heatbitinc/bitair-mainboard/3d/Heatsink.STEP

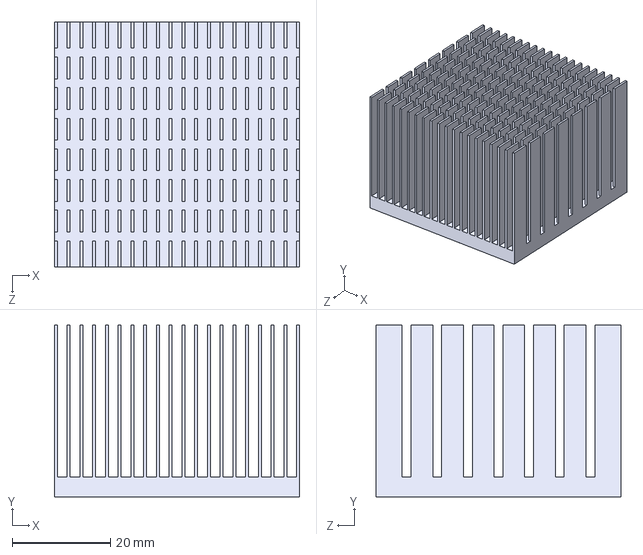
[picture p3: CAD file, 2026-10-29]
3d/Heatsink.STEP
50.0 x 35.0 x 50.0 mm
