heatbitinc/bitair-mainboard/3dshapes/IND-SMD_L10.2-W7.8.step

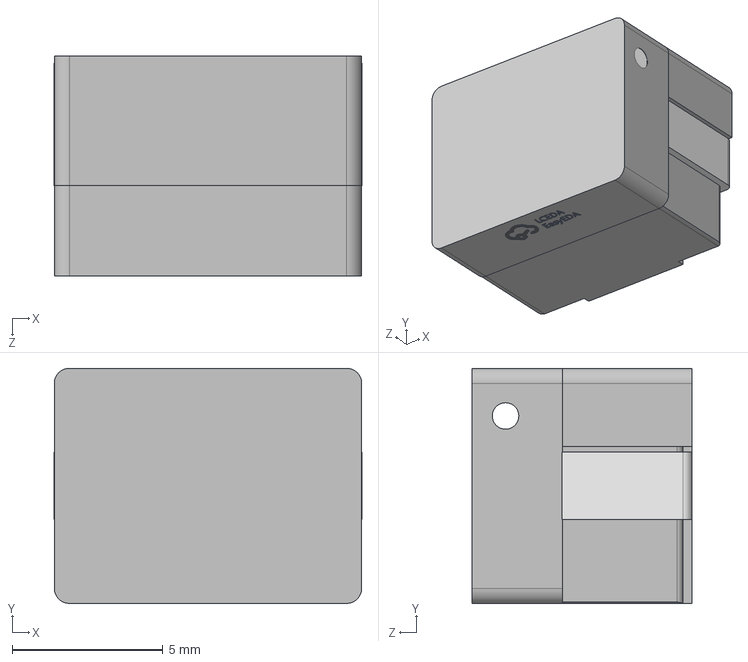
[picture p4: CAD file, 2026-10-29]
3dshapes/IND-SMD_L10.2-W7.8.step
10.2 x 7.81 x 7.31 mm
