heatbitinc/bitair-mainboard/3d/KMS231GPLFS.stp

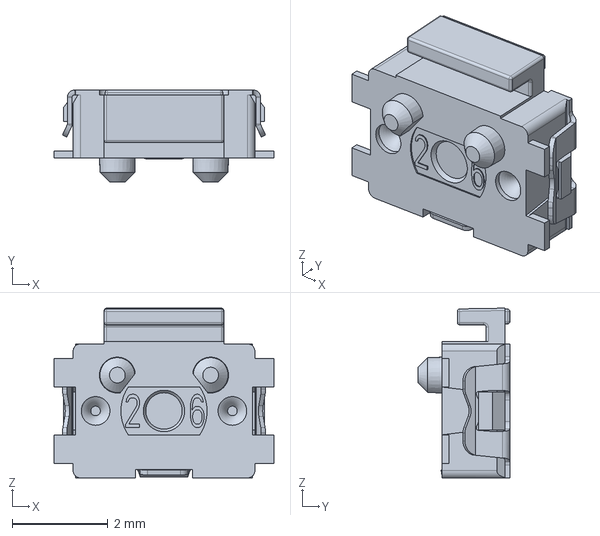
[picture p5: CAD file, 2026-10-29]
3d/KMS231GPLFS.stp
4.60 x 1.92 x 3.55 mm
