heatbitinc/bitair-mainboard/3dshapes/PRPAK-8_L5.1-W6.2-P1.27-LS6.1-BL.step

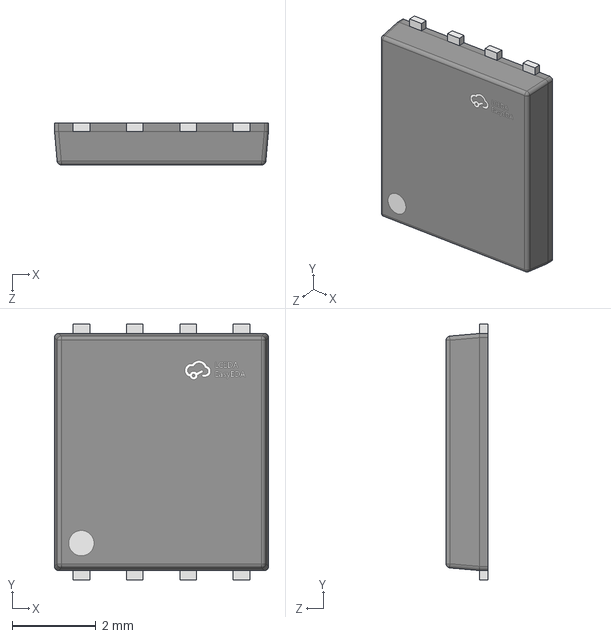
[picture p6: CAD file, 2026-10-29]
3dshapes/PRPAK-8_L5.1-W6.2-P1.27-LS6.1-BL.step
5.10 x 6.10 x 1.00 mm
