heatbitinc/bitair-mainboard/3dshapes/XFCN_PKT-TH_4P-T34069.step

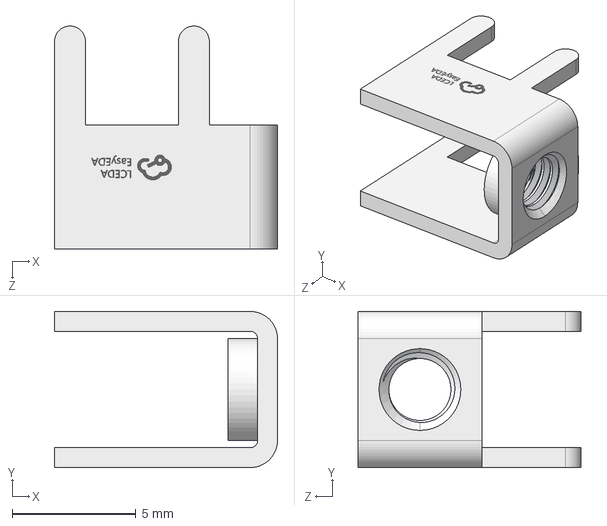
[picture p7: CAD file, 2026-10-29]
3dshapes/XFCN_PKT-TH_4P-T34069.step
9.00 x 6.30 x 9.00 mm
