heatbitinc/bitair-mainboard/3dshapes/SMD_BD5.6-D4.1.step

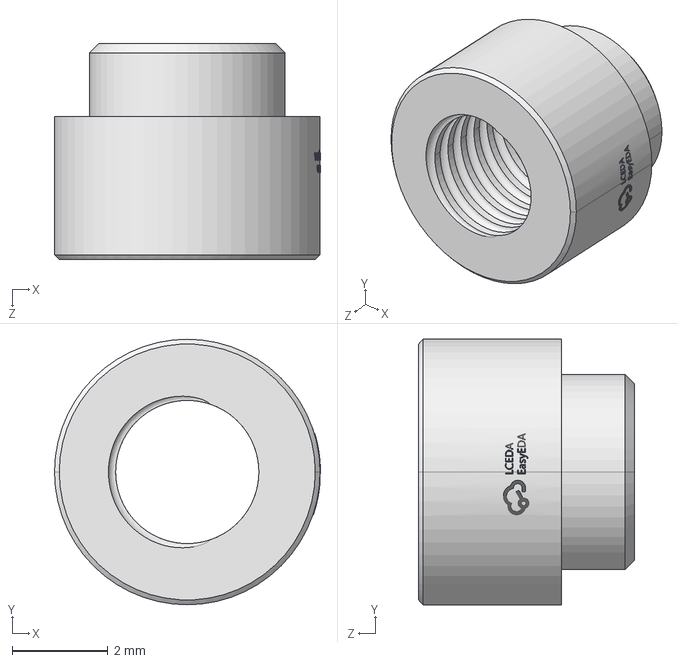
[picture p8: CAD file, 2026-10-29]
3dshapes/SMD_BD5.6-D4.1.step
5.57 x 5.56 x 4.53 mm
