heatbitinc/bitair-mainboard/bitair-mainboard.kicad_pcb

## KiCad design bitair-mainboard.kicad_pcb (2026-10-29)

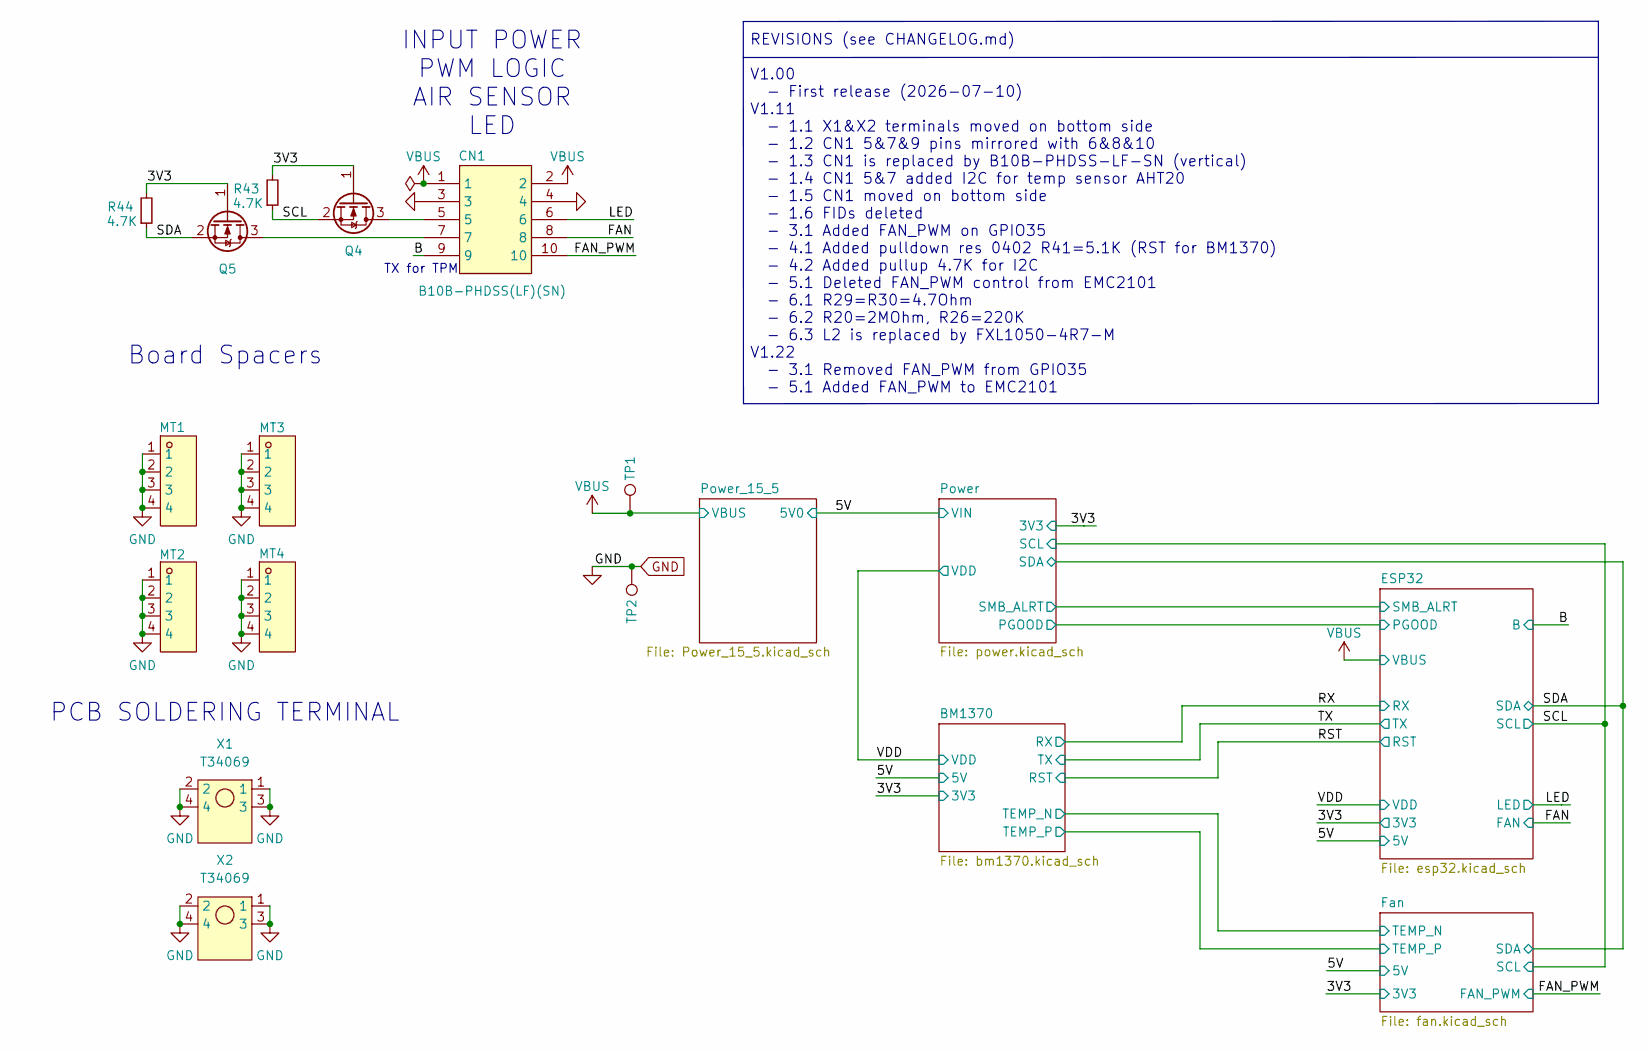
[picture p9: schematic bitair-mainboard.kicad_sch, Bitair MainBoard]

Parts:
CN1: B10B-PHDSS(LF)(SN); CONN-TH_B10B-PHDSS-LF-SN; MPN B10B-PHDSS(LF)(SN); LCSC C471519
MT1, MT2, MT3, MT4: SMTSO3025CTJ; SMD_BD5.6-D4.1; MPN SMTSO3025CTJ; LCSC C2916365
Q4, Q5: 2N7002E; SOT-23; MPN 2N7002ET1G; LCSC C71533
R43, R44: 4.7K; R_0402_1005Metric; LCSC C2906869
TP1, TP2: TestPoint; TestPoint_Pad_D1.5mm
X1, X2: T34069; XFCN_PKT-TH_4P-T34069; MPN T34069; LCSC C481452

Connections:
/3V3: Q4.1 (G), Q5.1 (G), R43.2, R44.2; also elsewhere on the board
/B: CN1.9; also elsewhere on the board
/FAN: CN1.8; also elsewhere on the board
/FAN_PWM: CN1.10; also elsewhere on the board
/LED: CN1.6; also elsewhere on the board
/SCL: Q4.2 (S), R43.1; also elsewhere on the board
/SDA: Q5.2 (S), R44.1; also elsewhere on the board
GND: CN1.3, CN1.4, MT1.1, MT1.2, MT1.3, MT1.4, MT2.1, MT2.2, MT2.3, MT2.4, MT3.1, MT3.2, MT3.3, MT3.4, MT4.1, MT4.2, MT4.3, MT4.4, TP2.1 (1_1), X1.1, X1.2, X1.3, X1.4, X2.1, X2.2, X2.3, X2.4; also elsewhere on the board
unnamed: CN1.5, Q4.3 (D)
unnamed: CN1.7, Q5.3 (D)
VBUS: CN1.1, CN1.2, TP1.1 (1_1); also elsewhere on the board

Notes on the sheet:
Board Spacers
PCB SOLDERING TERMINAL
INPUT POWER PWM LOGIC AIR SENSOR LED
REVISIONS (see CHANGELOG.md) V1.00 - First release (2026-07-10) V1.11 - 1.1 X1&X2 terminals moved on bottom side - 1.2 CN1 5&7&9 pins mirrored with 6&8&10 - 1.3 CN1 is replaced by B10B-PHDSS-LF-SN (vertical) - 1.4 CN1 5&7 added I2C for temp sensor AHT20 - 1.5 CN1 moved on bottom side - 1.6 FIDs del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
TX for TPM

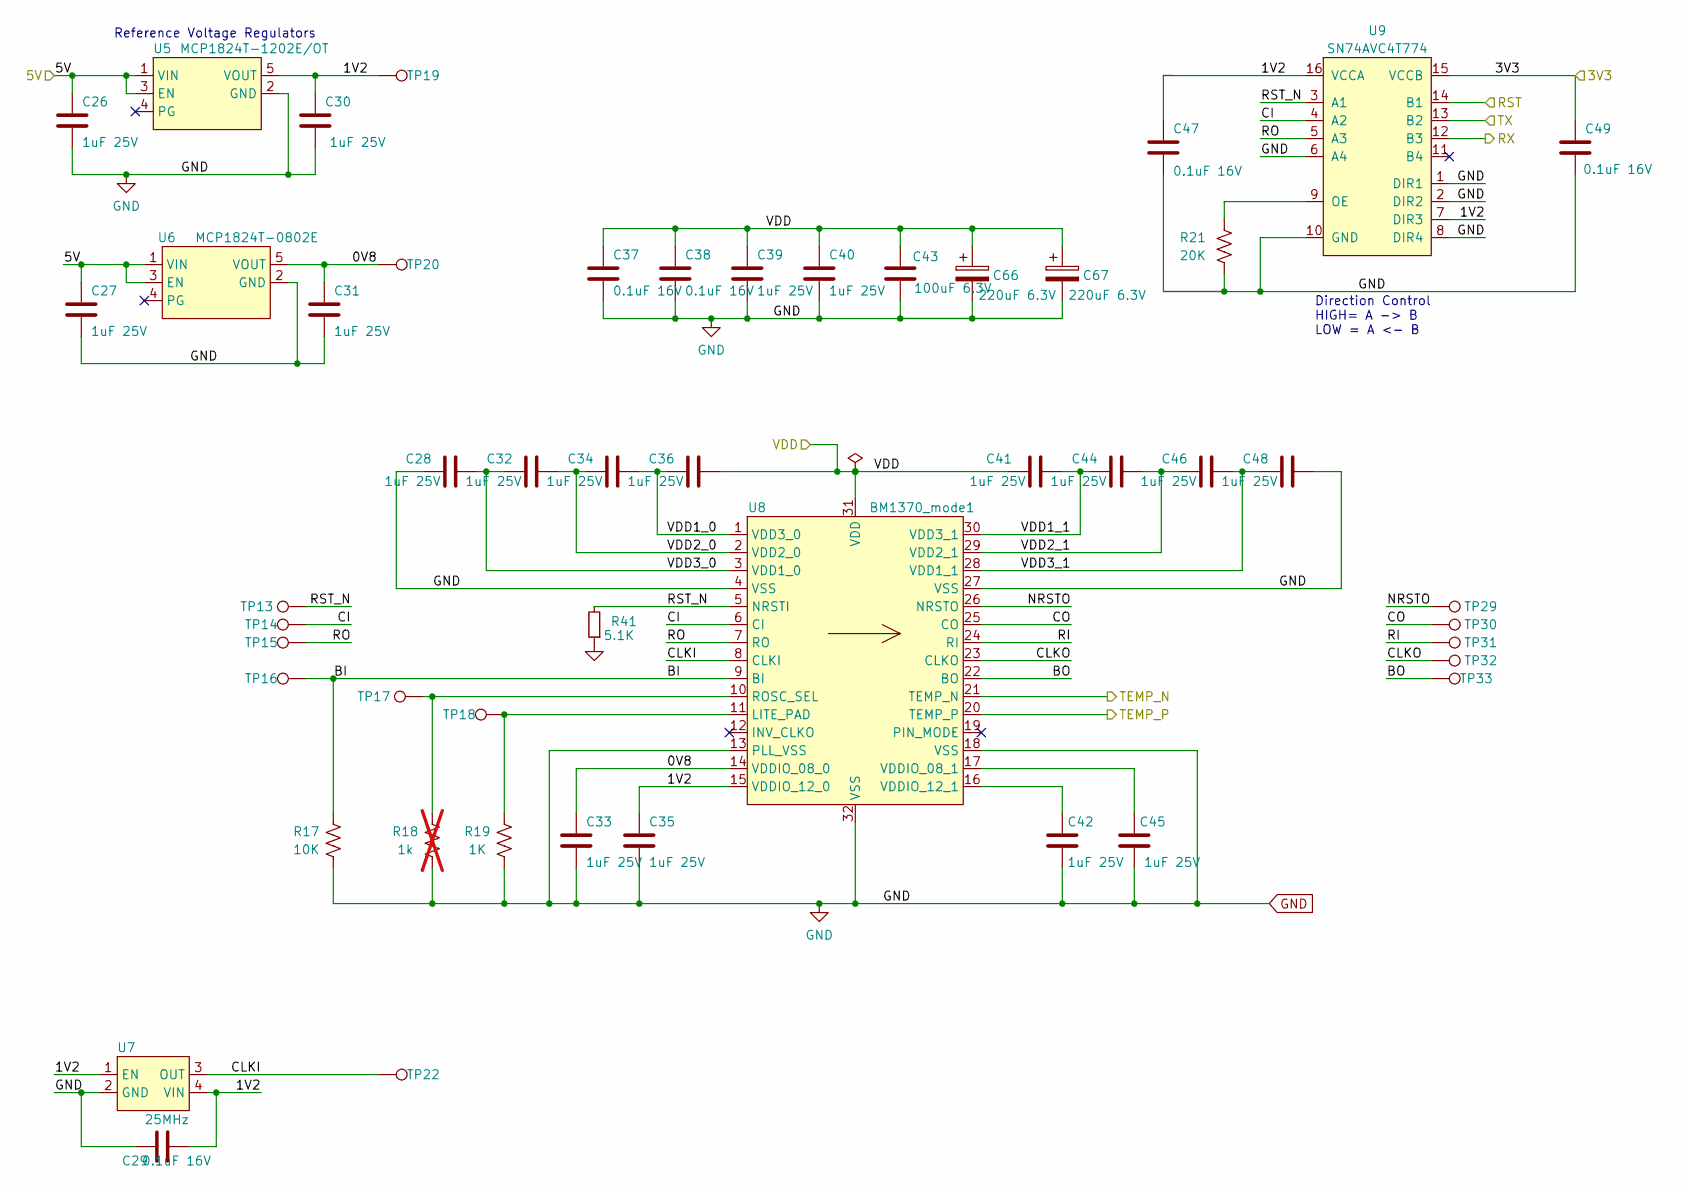
[picture p10: schematic bm1370.kicad_sch, Bitair MainBoard]

Parts:
C26, C27, C28, C30, C31, C32, C33, C34, C35, C36, C39, C40, C41, C42, C44, C45, C46, C48: 1uF 25V; C_0402_1005Metric; LCSC C7467048
C29, C37, C38, C47, C49: 0.1uF 16V; C_0402_1005Metric; DigiKey 1276-1234-1-ND
C43: 100uF 6.3V; C_1206_3216Metric; DigiKey 1276-1782-1-ND
C66, C67: 220uF 6.3V; CAP-SMD_L3.5-W2.8-R-RD; MPN 6TPE220MAZB; LCSC C79111
R17: 10K; R_0402_1005Metric; DigiKey 311-10KJRCT-ND
R18: 1k; R_0402_1005Metric; DigiKey 311-1.00KLRCT-ND; not fitted
R19: 1K; R_0402_1005Metric; DigiKey 311-1.00KLRCT-ND
R21: 20K; R_0402_1005Metric; DigiKey 311-20.0KLRCT-ND
R41: 5.1K; R_0402_1005Metric; LCSC C2906874
TP13, TP14, TP15, TP16, TP17, TP18, TP19, TP20, TP22, TP29, TP30, TP31, TP32, TP33: TestPoint; TestPoint_Pad_D1.5mm
U5: MCP1824T-1202E/OT; SOT-23-5; MPN MCP1824T-1202E/OT; DigiKey MCP1824T-1202E/OTCT-ND
U6: MCP1824T-0802E; SOT-23-5; MPN MCP1824T-0802E/OT; DigiKey MCP1824T-0802E/OTCT-ND
U7: 25MHz; SMD3225-4P; MPN SX3M25.000E20F30THN; LCSC C5137262
U8: BM1370_mode1; BM1370; MPN BM1370
U9: SN74AVC4T774; TSSOP-16_4.4x5mm_P0.65mm; MPN SN74AVC4T774PWR; DigiKey 296-24739-1-ND

Connections:
5V0: C26.1, C27.1, U5.1 (VIN), U5.3 (EN), U6.1 (VIN), U6.3 (EN); also elsewhere on the board
/3V3: C49.1, U9.15 (VCCB); also elsewhere on the board
/BM1370/0V8: C31.1, C33.1, TP20.1 (1_1), U6.5 (VOUT), U8.14 (VDDIO_08_0)
/BM1370/1V2: C29.2, C30.1, C35.1, C47.1, TP19.1 (1_1), U5.5 (VOUT), U7.1 (EN), U7.4 (VIN), U8.15 (VDDIO_12_0), U9.7 (DIR3), U9.16 (VCCA)
/BM1370/BI: R17.2, TP16.1 (1_1), U8.9 (BI)
/BM1370/BO: TP33.1 (1_1), U8.22 (BO)
/BM1370/CI: TP14.1 (1_1), U8.6 (CI), U9.4 (A2)
/BM1370/CLKI: TP22.1 (1_1), U7.3 (OUT), U8.8 (CLKI)
/BM1370/CLKO: TP32.1 (1_1), U8.23 (CLKO)
/BM1370/CO: TP30.1 (1_1), U8.25 (CO)
/BM1370/NRSTO: TP29.1 (1_1), U8.26 (NRSTO)
/BM1370/RI: TP31.1 (1_1), U8.24 (RI)
/BM1370/RO: TP15.1 (1_1), U8.7 (RO), U9.5 (A3)
/BM1370/RST_N: R41.2, TP13.1 (1_1), U8.5 (NRSTI), U9.3 (A1)
/BM1370/VDD1_0: C34.2, C36.1, U8.1 (VDD3_0)
/BM1370/VDD1_1: C41.2, C44.1, U8.30 (VDD3_1)
/BM1370/VDD2_0: C32.2, C34.1, U8.2 (VDD2_0)
/BM1370/VDD2_1: C44.2, C46.1, U8.29 (VDD2_1)
/BM1370/VDD3_0: C28.2, C32.1, U8.3 (VDD1_0)
/BM1370/VDD3_1: C46.2, C48.1, U8.28 (VDD1_1)
/Fan/TEMP_N: U8.21 (TEMP_N); also elsewhere on the board
/Fan/TEMP_P: U8.20 (TEMP_P); also elsewhere on the board
/RST: U9.14 (B1); also elsewhere on the board
/RX: U9.12 (B3); also elsewhere on the board
/TX: U9.13 (B2); also elsewhere on the board
/VDD: C36.2, C37.1, C38.1, C39.1, C40.1, C41.1, C43.1, C66.1, C67.1, U8.31 (VDD); also elsewhere on the board
GND: C26.2, C27.2, C28.1, C29.1, C30.2, C31.2, C33.2, C35.2, C37.2, C38.2, C39.2, C40.2, C42.2, C43.2, C45.2, C47.2, C48.2, C49.2, C66.2, C67.2, R17.1, R18.1, R19.1, R21.1, R41.1, U5.2 (GND), U6.2 (GND), U7.2 (GND), U8.4 (VSS), U8.13 (PLL_VSS), U8.18 (VSS), U8.27 (VSS), U8.32 (VSS), U9.1 (DIR1), U9.2 (DIR2), U9.6 (A4), U9.8 (DIR4), U9.10 (GND); also elsewhere on the board
unnamed: R19.2, TP18.1 (1_1), U8.11 (LITE_PAD)
unnamed: R18.2, TP17.1 (1_1), U8.10 (ROSC_SEL)
unnamed: C45.1, U8.17 (VDDIO_08_1)
unnamed: C42.1, U8.16 (VDDIO_12_1)
unnamed: R21.2, U9.9 (OE)

Notes on the sheet:
Reference Voltage Regulators
Direction Control HIGH= A -> B LOW = A <- B

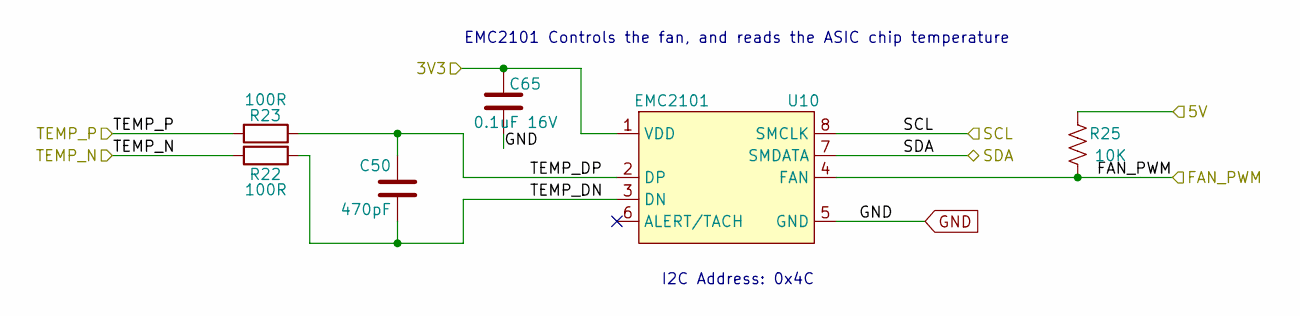
[picture p11: schematic fan.kicad_sch, Bitair MainBoard]

Parts:
C50: 470pF; C_0402_1005Metric; DigiKey 1276-1566-1-ND
C65: 0.1uF 16V; C_0402_1005Metric; LCSC C159816
R22, R23: 100R; R_0402_1005Metric; LCSC C144808
R25: 10K; R_0402_1005Metric; DigiKey 311-10KJRCT-ND
U10: EMC2101; TSSOP-8_3x3mm_P0.65mm; MPN EMC2101-R-ACZL-TR; DigiKey EMC2101-R-ACZL-CT-ND

Connections:
5V0: R25.2; also elsewhere on the board
/3V3: C65.1, U10.1 (VDD); also elsewhere on the board
/FAN_PWM: R25.1, U10.4 (FAN); also elsewhere on the board
/Fan/TEMP_DN: C50.2, R22.1, U10.3 (DN)
/Fan/TEMP_DP: C50.1, R23.1, U10.2 (DP)
/Fan/TEMP_N: R22.2; also elsewhere on the board
/Fan/TEMP_P: R23.2; also elsewhere on the board
/SCL: U10.8 (SMCLK); also elsewhere on the board
/SDA: U10.7 (SMDATA); also elsewhere on the board
GND: C65.2, U10.5 (GND); also elsewhere on the board

Notes on the sheet:
EMC2101 Controls the fan, and reads the ASIC chip temperature
I2C Address: 0x4C

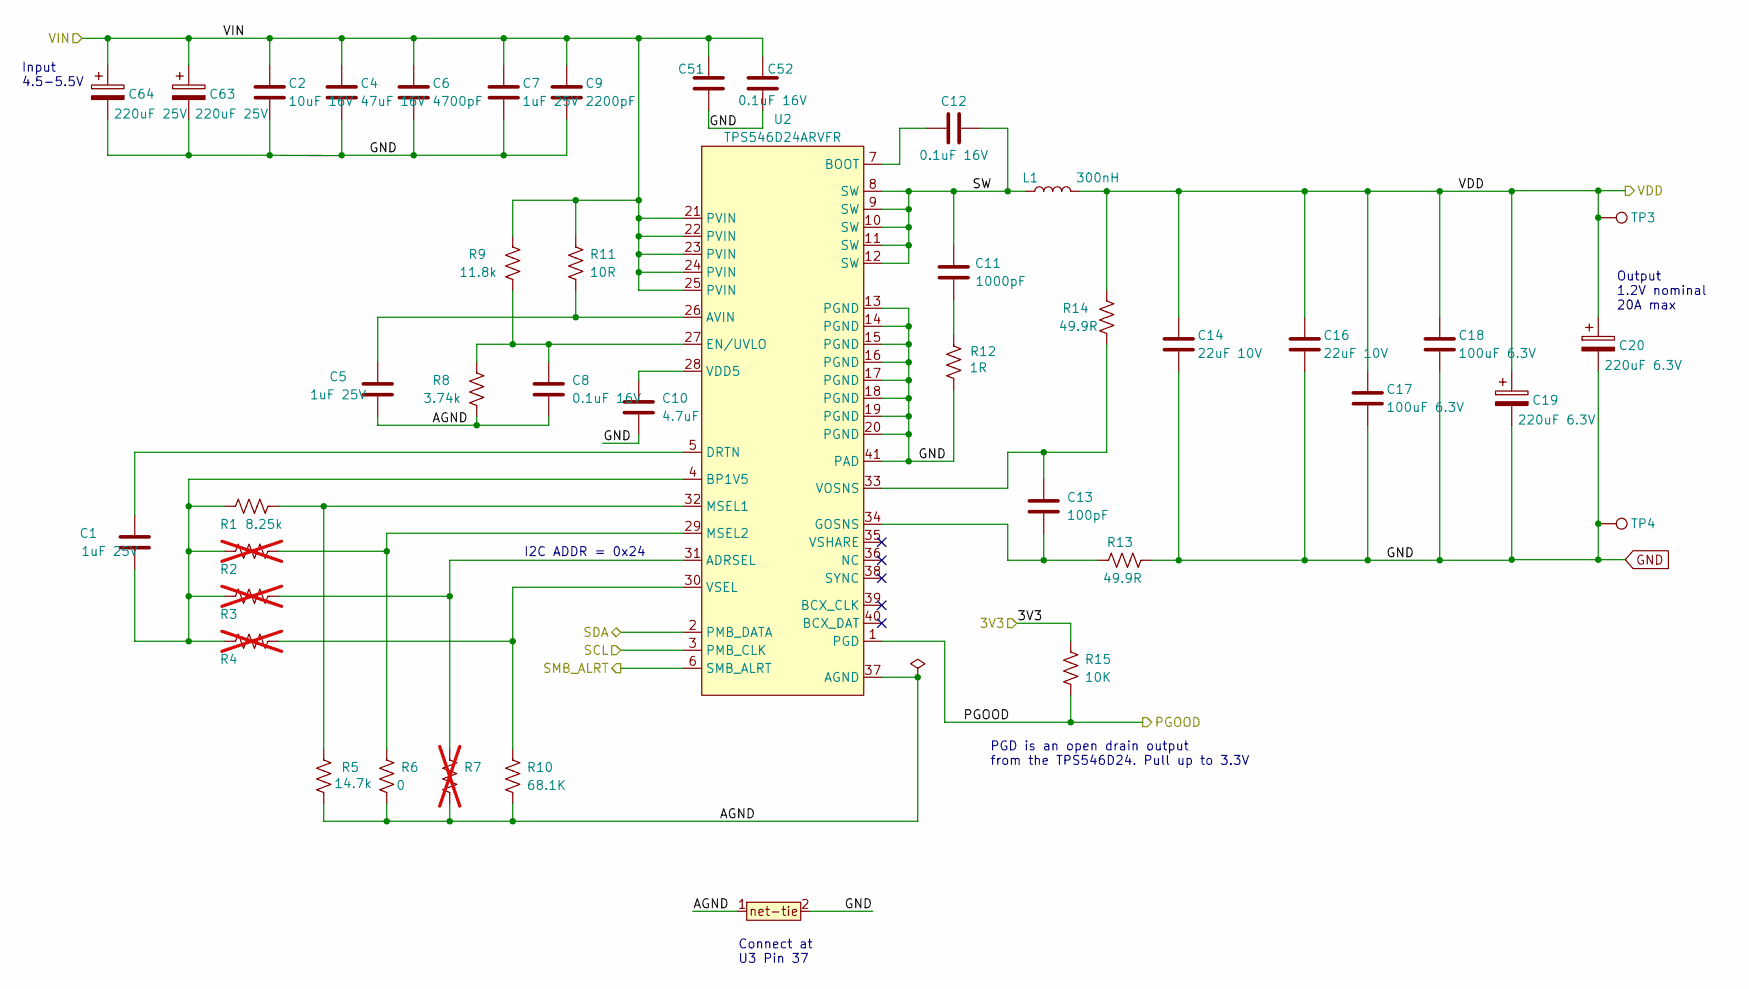
[picture p12: schematic power.kicad_sch, Bitair MainBoard]

Parts:
C1, C5, C7: 1uF 25V; C_0402_1005Metric; LCSC C7467048
C2: 10uF 16V; C_0805_2012Metric; DigiKey 1276-1096-1-ND
C4, C51: 47uF 16V; C_1210_3225Metric; DigiKey 1276-3376-1-ND
C6: 4700pF; C_0402_1005Metric; DigiKey 490-1309-1-ND
C8, C12, C52: 0.1uF 16V; C_0402_1005Metric; DigiKey 1276-1234-1-ND
C9: 2200pF; C_0402_1005Metric; DigiKey 490-8257-1-ND
C10: 4.7uF; C_0402_1005Metric; DigiKey 490-14306-1-ND
C11: 1000pF; C_0805_2012Metric; DigiKey 311-1127-1-ND
C13: 100pF; C_0402_1005Metric; DigiKey 732-7431-1-ND
C14, C16: 22uF 10V; C_0805_2012Metric; DigiKey 490-10746-1-ND
C17, C18: 100uF 6.3V; C_1206_3216Metric; DigiKey 1276-1782-1-ND
C19, C20: 220uF 6.3V; CAP-SMD_L3.5-W2.8-R-RD; MPN 6TPE220MAZB; LCSC C79111
C63, C64: 220uF 25V; CP_Elec_6.3x7.9; MPN JVJ25V220M6x8; LCSC C51018389
L1: 300nH; SLC1175-271MEC_COC; MPN FP1007R3-R30-R; LCSC C2638821
R1: 8.25k; R_0402_1005Metric; DigiKey 311-8.25KLRCT-ND
R2, R3, R4, R7: R_0402_1005Metric; not fitted
R5: 14.7k; R_0402_1005Metric; DigiKey YAG2984CT-ND
R6: 0; R_0402_1005Metric; DigiKey 311-0.0JRCT-ND
R8: 3.74k; R_0402_1005Metric; DigiKey 311-3.74KLRCT-ND
R9: 11.8k; R_0402_1005Metric; DigiKey YAG2958CT-ND
R10: 68.1K; R_0402_1005Metric; DigiKey YAG3213CT-ND
R11: 10R; R_0402_1005Metric; DigiKey 311-10.0LRCT-ND
R12: 1R; R_1206_3216Metric; DigiKey CSR1206FT1R00CT-ND
R13, R14: 49.9R; R_0402_1005Metric; DigiKey 311-49.9LRCT-ND
R15: 10K; R_0402_1005Metric; DigiKey 311-10KJRCT-ND
T1: net-tie; NetTie-0.25mm
TP3, TP4: TestPoint; TestPoint_Pad_D1.5mm
U2: TPS546D24ARVFR; LQFN40-CLIP; MPN TPS546D24ARVFR; DigiKey 296-TPS546D24ARVFRCT-ND

Connections:
5V0: C2.1, C4.1, C6.1, C7.1, C9.1, C51.1, C52.1, C63.1, C64.1, R9.1, R11.1, U2.21 (PVIN), U2.22 (PVIN), U2.23 (PVIN), U2.24 (PVIN), U2.25 (PVIN); also elsewhere on the board
/3V3: R15.2; also elsewhere on the board
/ESP32/SMB_ALRT: U2.6 (SMB_ALRT); also elsewhere on the board
/Power/AGND: C5.1, C8.2, R5.1, R6.2, R7.2, R8.2, R10.2, T1.1, U2.37 (AGND)
/Power/PGOOD: R15.1, U2.1 (PGD); also elsewhere on the board
/Power/SW: C11.2, C12.2, L1.1, U2.8 (SW), U2.9 (SW), U2.10 (SW), U2.11 (SW), U2.12 (SW)
/SCL: U2.3 (PMB_CLK); also elsewhere on the board
/SDA: U2.2 (PMB_DATA); also elsewhere on the board
/VDD: C14.1, C16.1, C17.1, C18.1, C19.1, C20.1, L1.2, R14.1, TP3.1 (1_1); also elsewhere on the board
GND: C2.2, C4.2, C6.2, C7.2, C9.2, C10.2, C14.2, C16.2, C17.2, C18.2, C19.2, C20.2, C51.2, C52.2, C63.2, C64.2, R12.1, R13.2, T1.2, TP4.1 (1_1), U2.13 (PGND), U2.14 (PGND), U2.15 (PGND), U2.16 (PGND), U2.17 (PGND), U2.18 (PGND), U2.19 (PGND), U2.20 (PGND), U2.41 (PAD); also elsewhere on the board
unnamed: C11.1, R12.2
unnamed: R3.2, R7.1, U2.31 (ADRSEL)
unnamed: C5.2, R11.2, U2.26 (AVIN)
unnamed: C12.1, U2.7 (BOOT)
unnamed: C1.2, R1.1, R2.1, R3.1, R4.1, U2.4 (BP1V5)
unnamed: C1.1, U2.5 (DRTN)
unnamed: C8.1, R8.1, R9.2, U2.27 (EN/UVLO)
unnamed: C13.2, R13.1, U2.34 (GOSNS)
unnamed: R1.2, R5.2, U2.32 (MSEL1)
unnamed: R2.2, R6.1, U2.29 (MSEL2)
unnamed: C10.1, U2.28 (VDD5)
unnamed: C13.1, R14.2, U2.33 (VOSNS)
unnamed: R4.2, R10.1, U2.30 (VSEL)

Notes on the sheet:
Input 4.5-5.5V
PGD is an open drain output from the TPS546D24. Pull up to 3.3V
I2C ADDR = 0x24
Output 1.2V nominal 20A max
Connect at U3 Pin 37

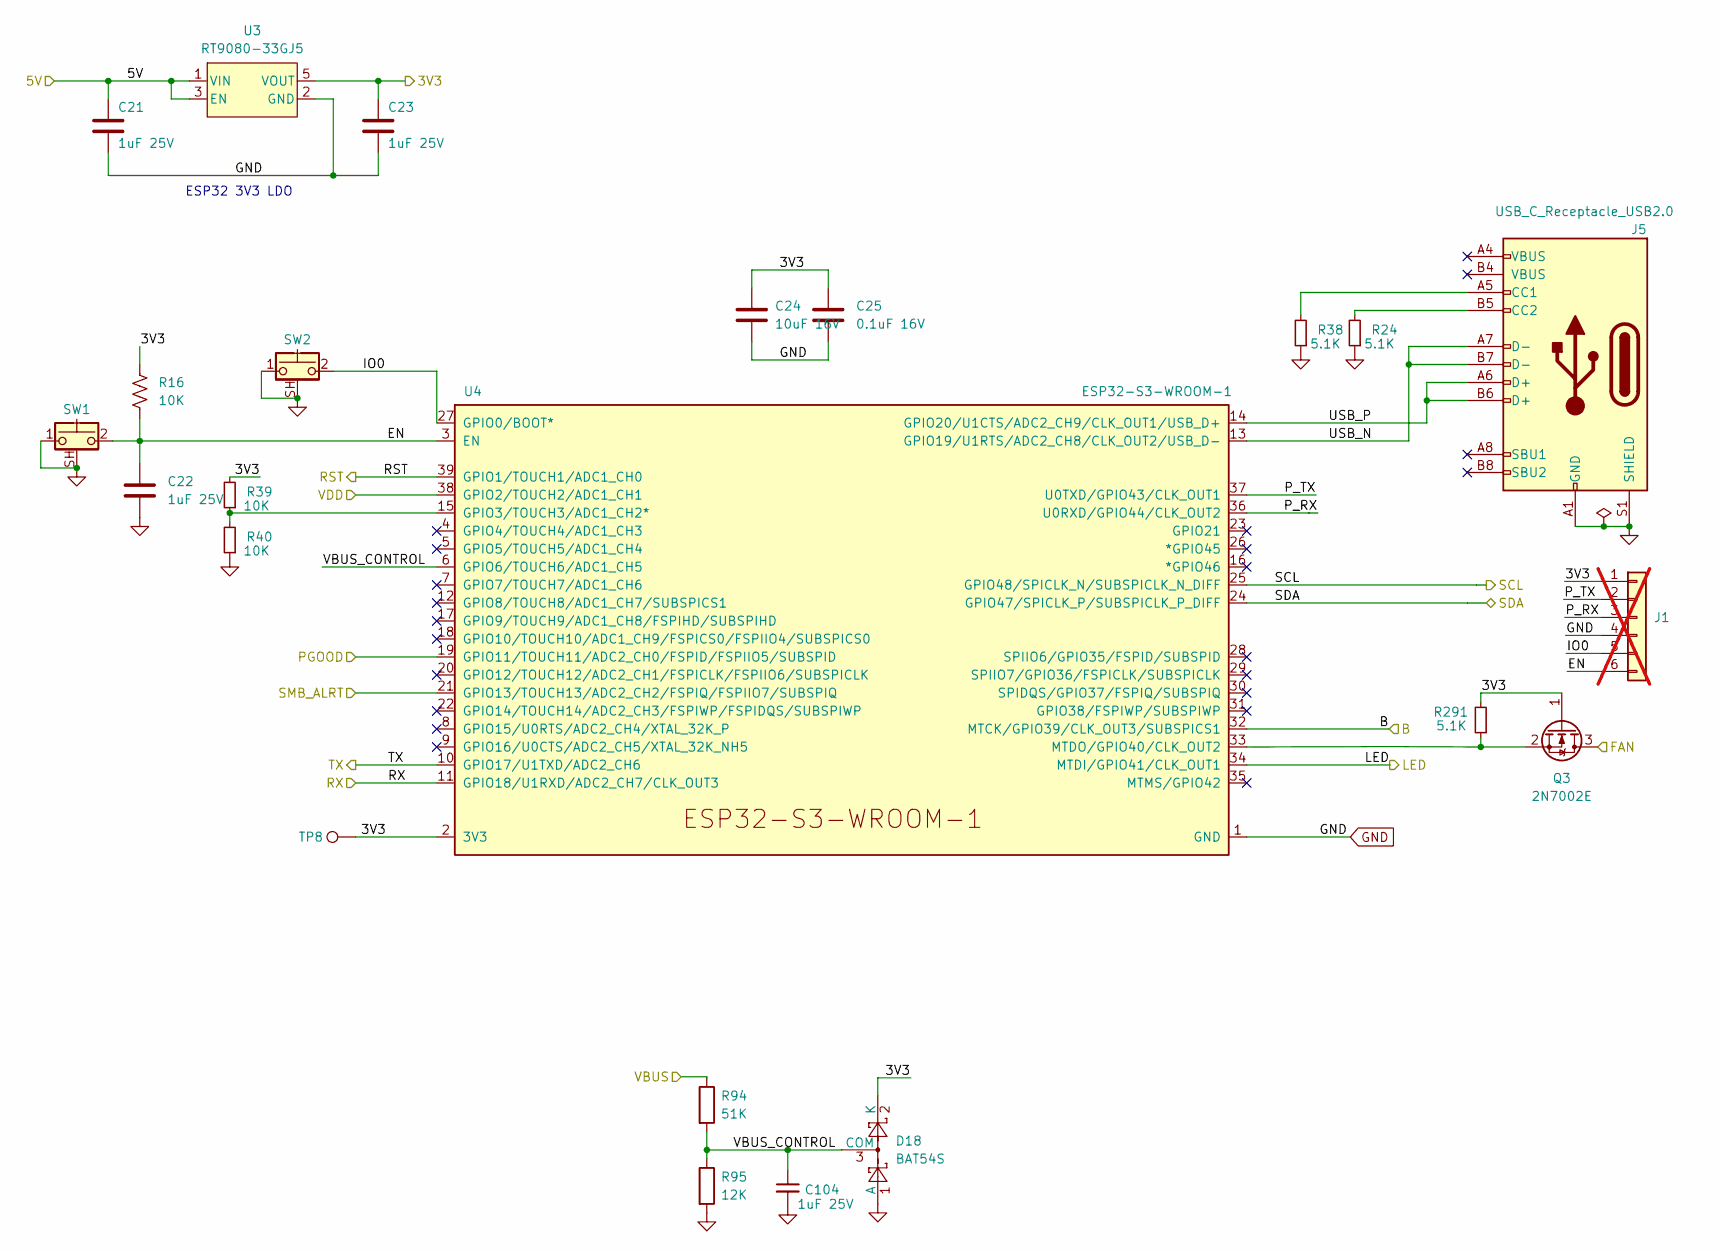
[picture p13: schematic esp32.kicad_sch, Bitair MainBoard]

Parts:
C21, C22, C23, C104: 1uF 25V; C_0402_1005Metric; LCSC C7467048
C24: 10uF 16V; C_0805_2012Metric; DigiKey 1276-1096-1-ND
C25: 0.1uF 16V; C_0402_1005Metric; DigiKey 1276-1234-1-ND
D18: BAT54S; SOT-23; MPN BAT54S; LCSC C19726
J1: Conn_01x06; PinHeader_1x06_P1.27mm_Vertical; MPN PZ254V-11-06P; LCSC C492405; not fitted
J5: USB_C_Receptacle_USB2.0; USB_C_Receptacle_GCT_USB4105-xx-A; MPN USB4105-GF-A; DigiKey 2073-USB4105-GF-ACT-ND
Q3: 2N7002E; SOT-23; MPN 2N7002ET1G; LCSC C71533
R16: 10K; R_0402_1005Metric; DigiKey 311-10KJRCT-ND
R24, R38, R291: 5.1K; R_0402_1005Metric; LCSC C2906874
R39, R40: 10K; R_0402_1005Metric; LCSC C60490
R94: 51K; R_0402_1005Metric; LCSC C409055
R95: 12K; R_0402_1005Metric; LCSC C2692918
SW1, SW2: CK_KMS2xxG; SW_SPST_CK_KMS2xxGP; MPN KMS231GLFS; LCSC C221703
TP8: TestPoint; TestPoint_Pad_D1.5mm
U3: RT9080-33GJ5; MPN RT9080-33GJ5; DigiKey 1028-1509-1-ND
U4: ESP32-S3-WROOM-1; MPN ESP32-S3-WROOM-1-N16R8; DigiKey 1965-ESP32-S3-WROOM-1-N16R8CT-ND

Connections:
5V0: C21.1, U3.1 (VIN), U3.3 (EN); also elsewhere on the board
/3V3: C23.1, C24.1, C25.1, D18.2 (K), J1.1, Q3.1 (G), R16.1, R39.2, R291.2, TP8.1 (1_1), U3.5 (VOUT), U4.2 (3V3); also elsewhere on the board
/B: U4.32 (MTCK/GPIO39/CLK_OUT3/SUBSPICS1); also elsewhere on the board
/ESP32/EN: C22.1, J1.6, R16.2, SW1.2, U4.3 (EN)
/ESP32/IO0: J1.5, SW2.2, U4.27 (GPIO0/BOOT*)
/ESP32/P_RX: J1.3, U4.36 (U0RXD/GPIO44/CLK_OUT2)
/ESP32/P_TX: J1.2, U4.37 (U0TXD/GPIO43/CLK_OUT1)
/ESP32/SMB_ALRT: U4.21 (GPIO13/TOUCH13/ADC2_CH2/FSPIQ/FSPIIO7/S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); also elsewhere on the board
/ESP32/USB_N: J5.A7 (D-), J5.B7 (D-), U4.13 (GPIO19/U1RTS/ADC2_CH8/CLK_OUT2/USB_D-)
/ESP32/USB_P: J5.A6 (D+), J5.B6 (D+), U4.14 (GPIO20/U1CTS/ADC2_CH9/CLK_OUT1/USB_D+)
/ESP32/VBUS_CONTROL: C104.1, D18.3 (COM), R94.2, R95.1, U4.6 (GPIO6/TOUCH6/ADC1_CH5)
/FAN: Q3.3 (D); also elsewhere on the board
/LED: U4.34 (MTDI/GPIO41/CLK_OUT1); also elsewhere on the board
/Power/PGOOD: U4.19 (GPIO11/TOUCH11/ADC2_CH0/FSPID/FSPIIO5/S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); also elsewhere on the board
/RST: U4.39 (GPIO1/TOUCH1/ADC1_CH0); also elsewhere on the board
/RX: U4.11 (GPIO18/U1RXD/ADC2_CH7/CLK_OUT3); also elsewhere on the board
/SCL: U4.25 (GPIO48/SPICLK_N/SUBSPICLK_N_DIFF); also elsewhere on the board
/SDA: U4.24 (GPIO47/SPICLK_P/SUBSPICLK_P_DIFF); also elsewhere on the board
/TX: U4.10 (GPIO17/U1TXD/ADC2_CH6); also elsewhere on the board
/VDD: U4.38 (GPIO2/TOUCH2/ADC1_CH1); also elsewhere on the board
GND: C21.2, C22.2, C23.2, C24.2, C25.2, C104.2, D18.1 (A), J1.4, J5.A1 (GND), J5.B1 (GND), J5.S1 (SHIELD), R24.1, R38.1, R40.1, R95.2, SW1.1, SW1.SH (B), SW2.1, SW2.SH (B), U3.2 (GND), U4.1 (GND), U4.40 (GND), U4.41 (GND); also elsewhere on the board
unnamed: J5.A5 (CC1), R38.2
unnamed: J5.B5 (CC2), R24.2
unnamed: Q3.2 (S), R291.1, U4.33 (MTDO/GPIO40/CLK_OUT2)
unnamed: R39.1, R40.2, U4.15 (GPIO3/TOUCH3/ADC1_CH2*)
VBUS: R94.1; also elsewhere on the board

Notes on the sheet:
ESP32 3V3 LDO

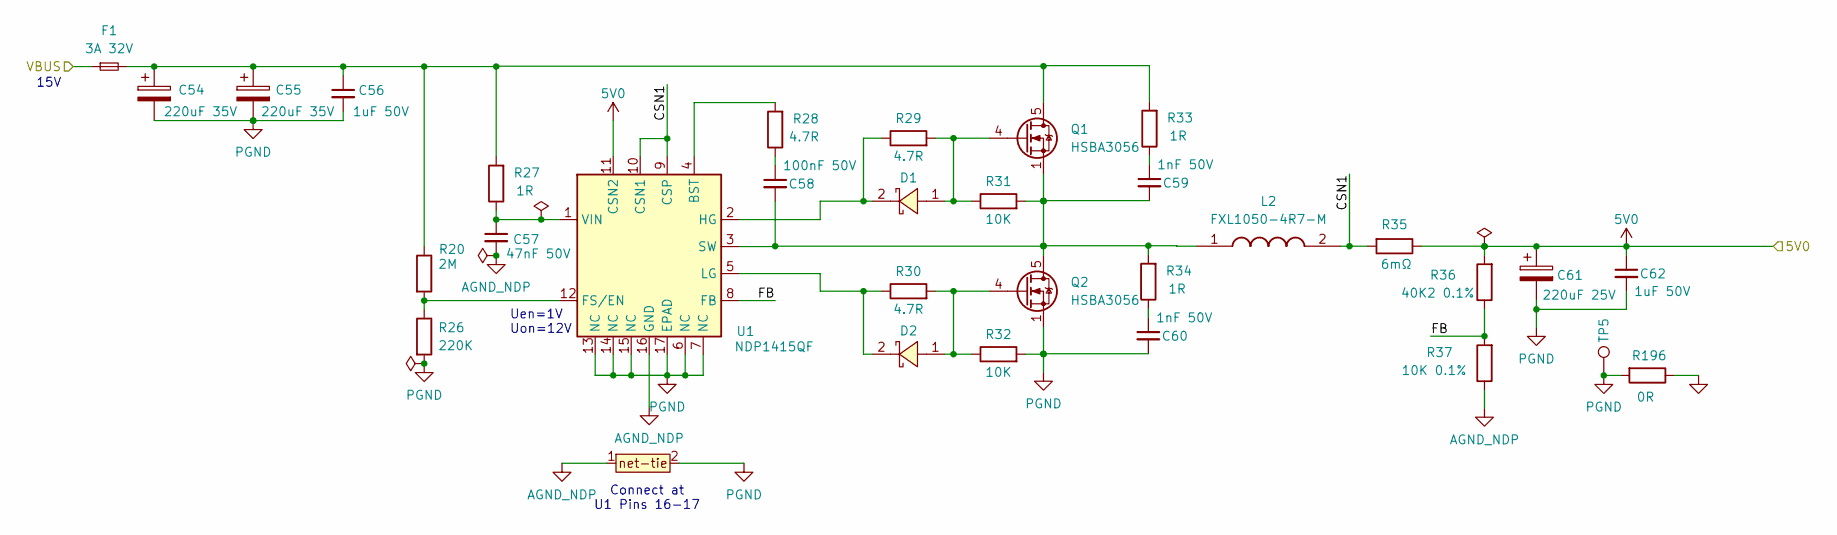
[picture p14: schematic Power_15_5.kicad_sch, Bitair MainBoard]

Parts:
C54, C55: 220uF 35V; CP_Elec_6.3x7.9; MPN JVJ35V220M6x8; LCSC C49256854
C56, C62: 1uF 50V; C_1206_3216Metric; LCSC C1848
C57: 47nF 50V; C_0805_2012Metric; LCSC C107154
C58: 100nF 50V; C_0603_1608Metric; LCSC C1591
C59, C60: 1nF 50V; C_0805_2012Metric; LCSC C94121
C61: 220uF 25V; CP_Elec_6.3x7.9; MPN JVJ25V220M6x8; LCSC C51018389
D1, D2: BAT46W; SOD-123_L2.7-W1.6-LS3.7-FD; MPN BAT46W; LCSC C7420332
F1: 3A 32V; Fuse_1206_3216Metric; MPN S1206-F-3.0A; LCSC C845163
L2: FXL1050-4R7-M; IND-SMD_L11.5-W10.0; MPN FXL1050-4R7-M; LCSC C5359261
Q1, Q2: HSBA3056; PRPAK-8_L5.1-W6.2-P1.27-LS6.1-BL; MPN HSBA3056; LCSC C701049
R20: 2M; R_0402_1005Metric; LCSC C138014
R26: 220K; R_0402_1005Metric; LCSC C2909335
R27: 1R; R_1206_3216Metric; LCSC C20476230
R28: 4.7R; R_0805_2012Metric; LCSC C2828871
R29, R30: 4.7R; R_0603_1608Metric; LCSC C2907035
R31, R32: 10K; R_0603_1608Metric; LCSC C98220
R33, R34: 1R; R_0805_2012Metric; LCSC C2907233
R35: 6mΩ; R_0805_2012Metric; MPN RLM10FTSMR006; LCSC C163092
R36: 40K2 0.1%; R_0603_1608Metric; LCSC C374525
R37: 10K 0.1%; R_0603_1608Metric; LCSC C95204
R196: 0R; R_1210_3225Metric; LCSC C2974058
T2: net-tie; NetTie-0.25mm
TP5: TestPoint; TestPoint_Pad_D1.5mm
U1: NDP1415QF; QFN-16_L3.0-W3.0-P0.50-BL-EP1.7; MPN NDP1415QF; LCSC C7420580

Connections:
5V0: C61.1, C62.1, R35.1, R36.2, U1.11 (CSN2); also elsewhere on the board
/Power_15_5/CSN1: L2.2, R35.2, U1.9 (CSP), U1.10 (CSN1)
/Power_15_5/FB: R36.1, R37.2, U1.8 (FB)
AGND_NDP: C57.2, R37.1, T2.1, U1.16 (GND)
GND: R196.1; also elsewhere on the board
unnamed: C54.1, C55.1, C56.1, F1.2, Q1.5 (D), Q1.6 (D), Q1.7 (D), Q1.8 (D), Q1.9 (D), R20.1, R27.2, R33.2
unnamed: C58.1, R28.1
unnamed: C59.1, R33.1
unnamed: C60.1, R34.1
unnamed: D1.1, Q1.4 (G), R29.2, R31.1
unnamed: D2.1, Q2.4 (G), R30.2, R32.1
unnamed: R28.2, U1.4 (BST)
unnamed: R20.2, R26.1, U1.12 (FS/EN)
unnamed: D1.2, R29.1, U1.2 (HG)
unnamed: D2.2, R30.1, U1.5 (LG)
unnamed: C58.2, C59.2, L2.1, Q1.1 (S), Q1.2 (S), Q1.3 (S), Q2.5 (D), Q2.6 (D), Q2.7 (D), Q2.8 (D), Q2.9 (D), R31.2, R34.2, U1.3 (SW)
unnamed: C57.1, R27.1, U1.1 (VIN)
PGND: C54.2, C55.2, C56.2, C60.2, C61.2, C62.2, Q2.1 (S), Q2.2 (S), Q2.3 (S), R26.2, R32.2, R196.2, T2.2, TP5.1 (1_1), U1.6 (NC), U1.7 (NC), U1.13 (NC), U1.14 (NC), U1.15 (NC), U1.17 (EPAD)
VBUS: F1.1; also elsewhere on the board

Notes on the sheet:
Connect at U1 Pins 16-17
Uen=1V Uon=12V
15V

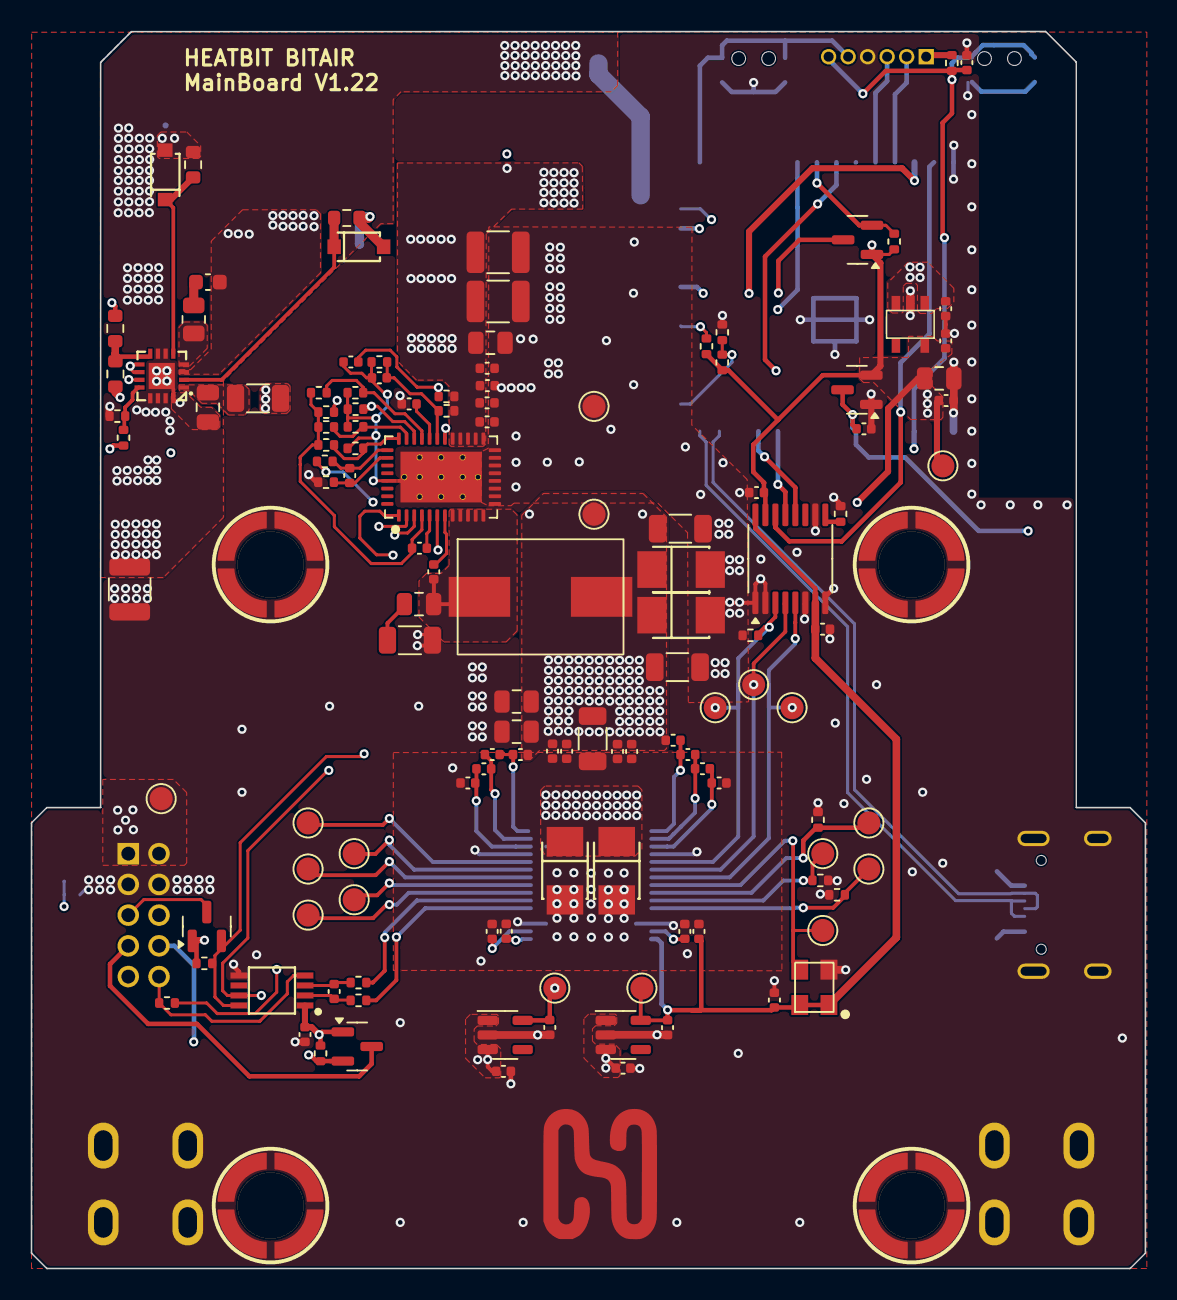
[picture p15: board bitair-mainboard.kicad_pcb from above]

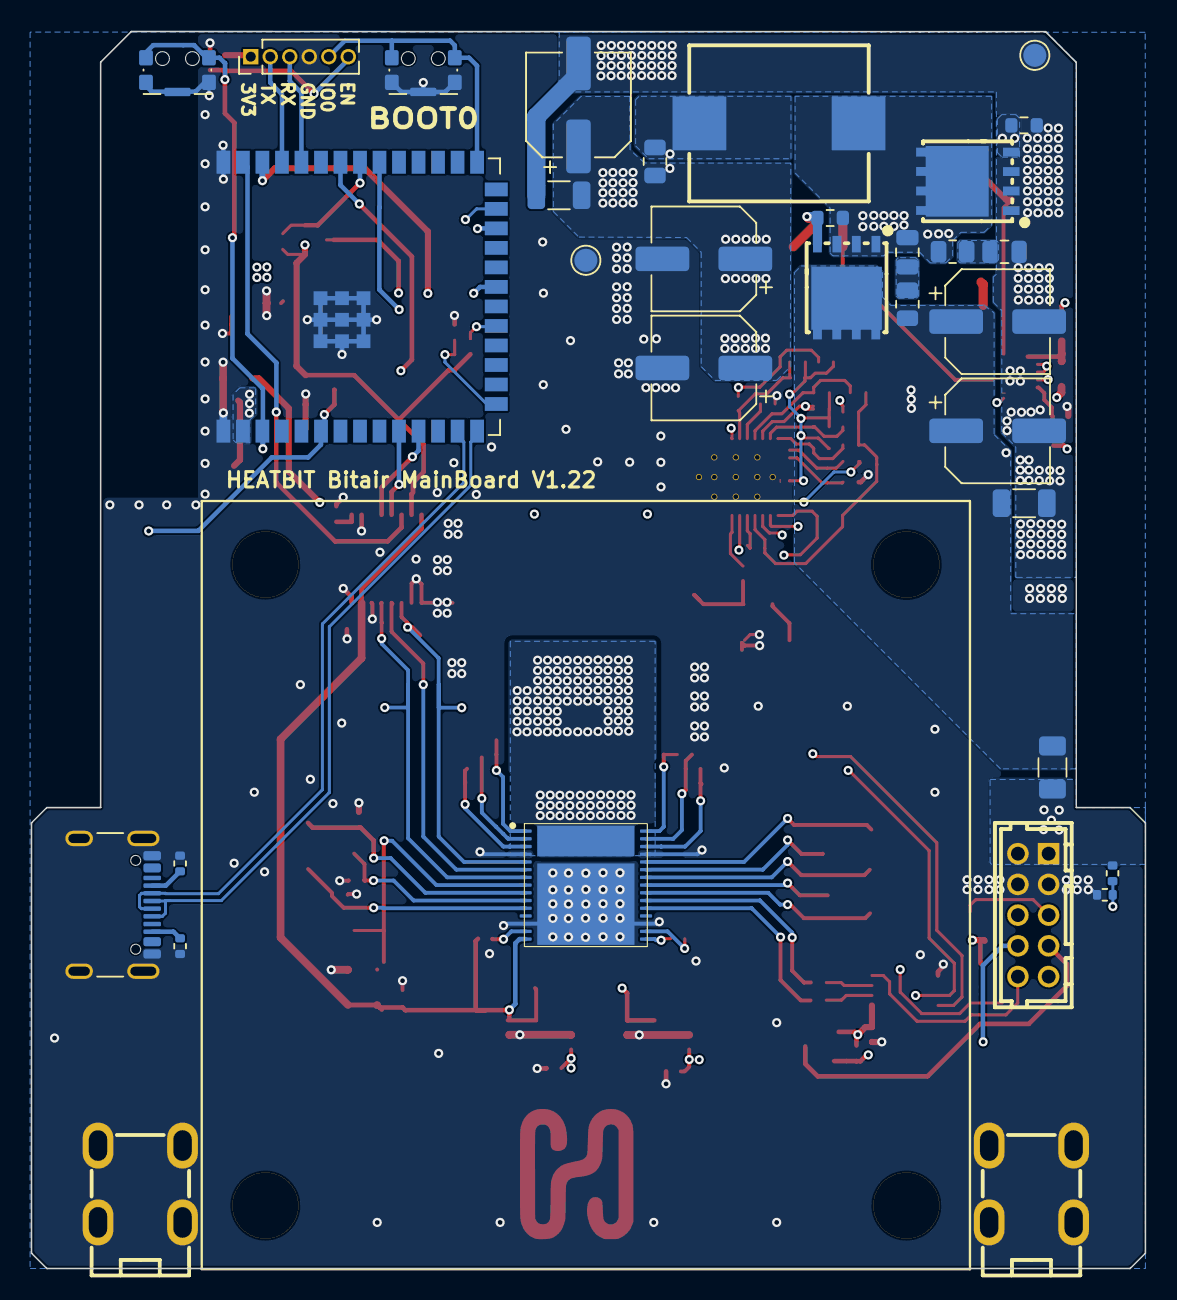
[picture p16: board bitair-mainboard.kicad_pcb from below]

Board: 4 copper layers, 72.5 x 80.5 mm, 166 parts (33 on the bottom side), 87 nets.
