heatbitinc/bitair-mainboard/(notices)

Notices in the files:
power.kicad_sch:
Based on bitaxeGamma (c) 2024-2025 bitaxeorg, github.com/bitaxeorg/bitaxeGamma
Modifications (c) 2026 Heatbit Inc. See NOTICE.md for the list of changes
Licensed under CERN-OHL-S-2.0 (see LICENSE)
